Utsab-2010/GC-Hamo-2025/README.md

# GC-Hamo-2025
## Video Demo
YouTube Video lF7_R72z5Hs (https://www.youtube.com/watch?v=lF7_R72z5Hs)
## Circuit Design
**Transmitter** & **Receiver**

transmitter
receiver

## CAD Design
[Link to CAD files](https://drive.google.com/drive/folders/1ofq2GxQTMj-k_FqcCt4ODpRAtsVdMHEt?usp=drive_link)

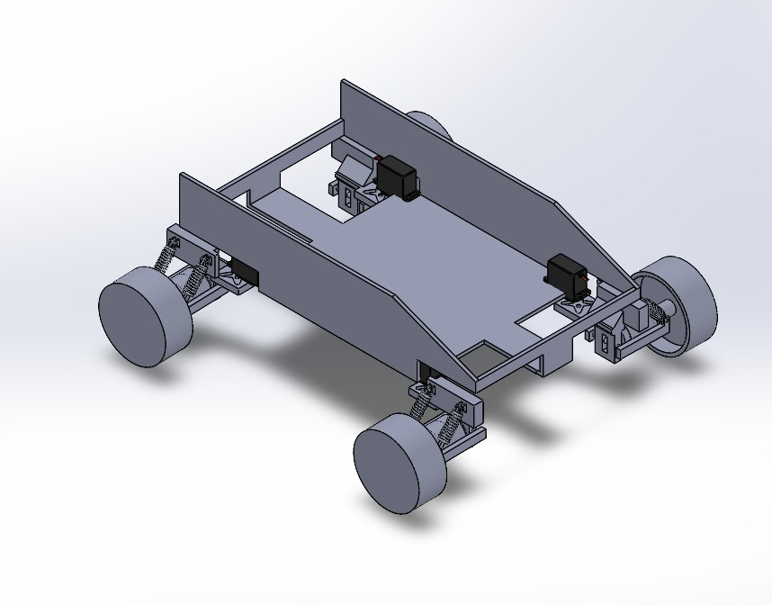
[picture p1: pictures/mode1_ortho.jpeg]
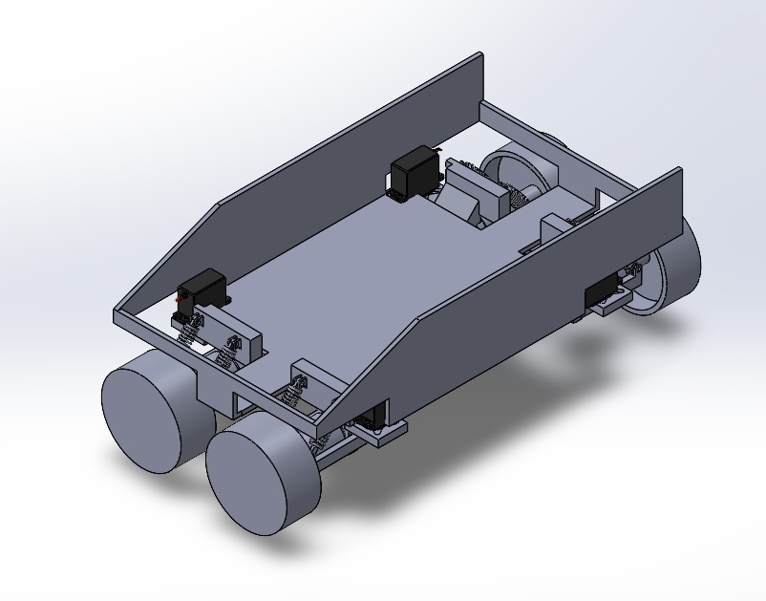
[picture p2: pictures/mode2_ortho.jpeg]
|  |  |
|:---:|:---:|
| **Mode 1: Driving** | **Mode 2: Parallel Parking** |

### Electronics Team
- Aritra
- Aryarup
- Debmalya
- Utsab
### Mech Team
- Shayantan
- Priyavrat
- Kunal
