Utsab-2010/GC-Hamo-2025/pictures/top.jpeg

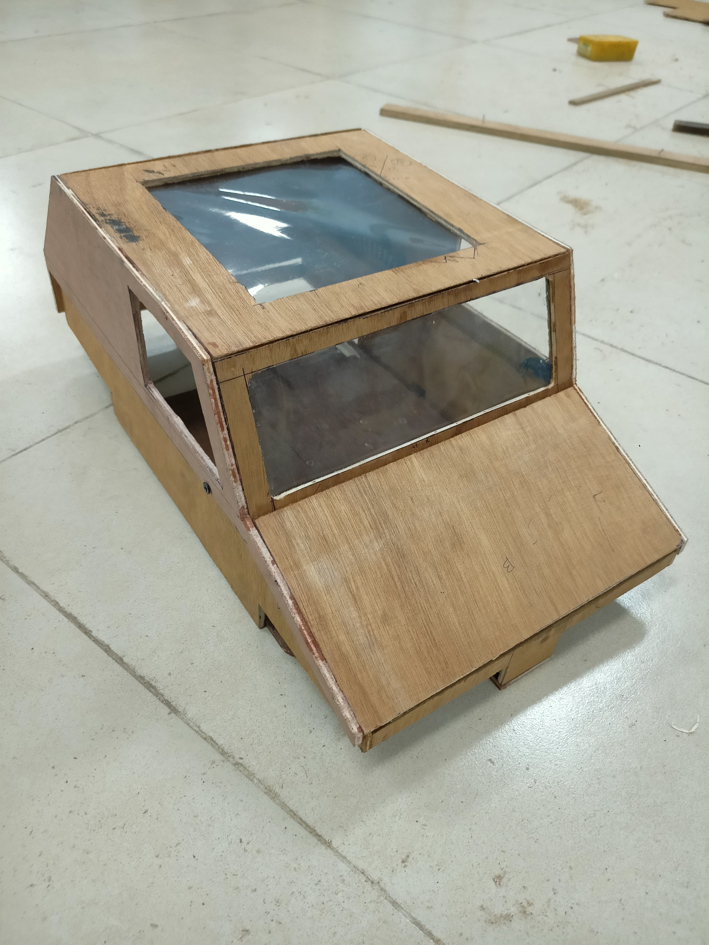
pictures/top.jpeg
