Utsab-2010/GC-Hamo-2025/hamo_result/hamo_result_1.jpeg

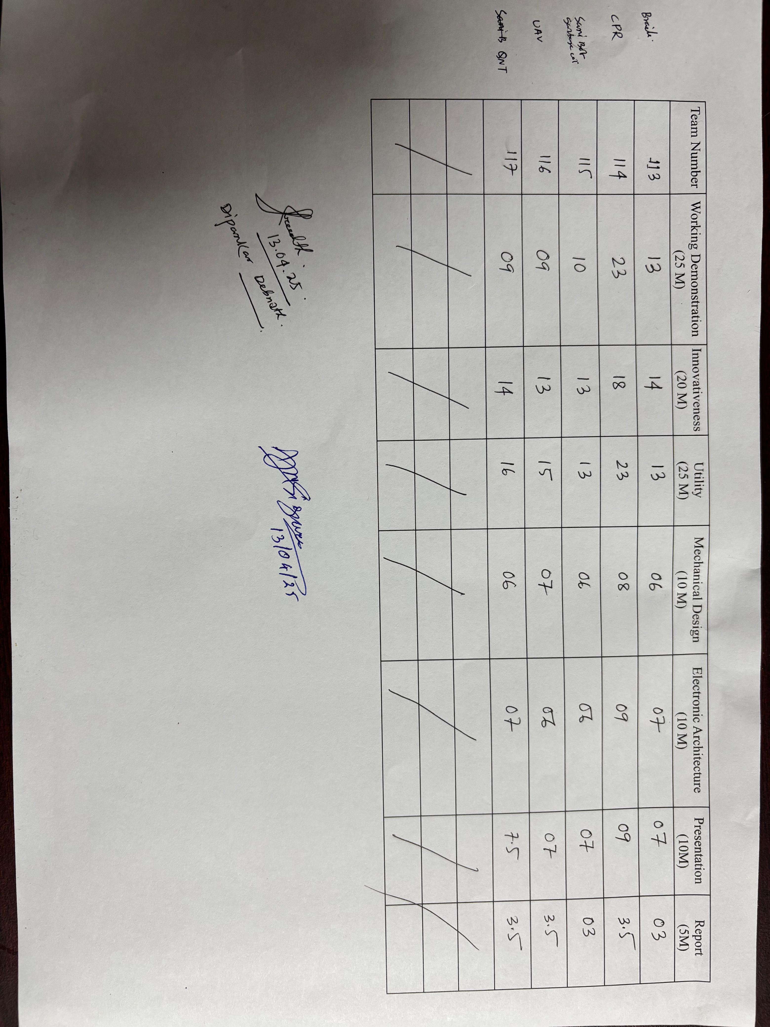
hamo_result/hamo_result_1.jpeg
