Utsab-2010/GC-Hamo-2025/hamo_result/hamo_result_2.jpeg

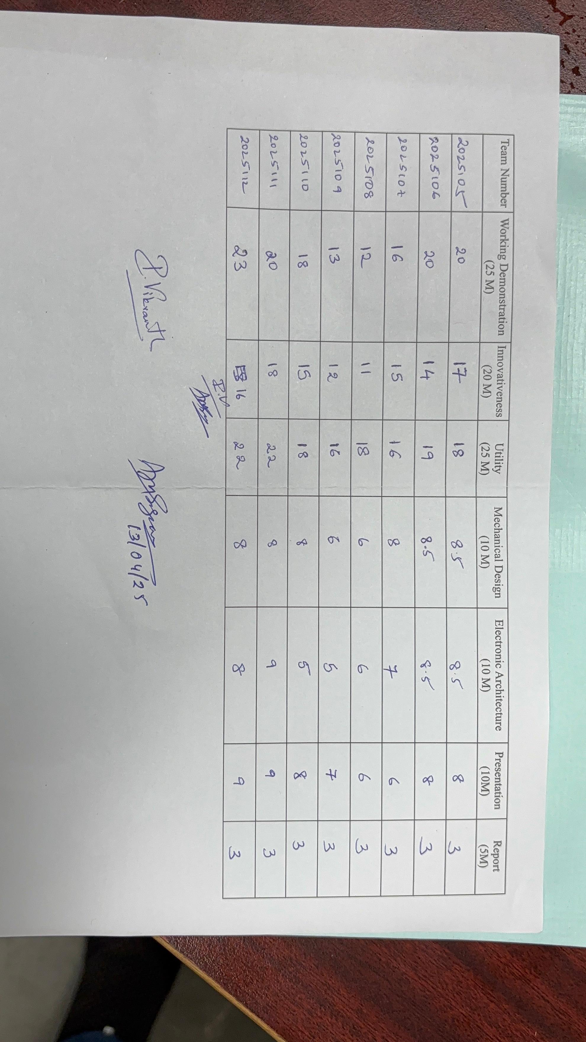
hamo_result/hamo_result_2.jpeg
