Utsab-2010/GC-Hamo-2025/(commit log)

2025-06-25 added the arduino files.
2025-11-02 Modify video link and add CAD files reference
    Updated YouTube video link and added CAD files link.
2025-11-02 Add images for CAD design modes
    Added images for driving and parallel parking modes.
